warthog9/halloween-vending-machine/halloween vending machine.kicad_sch

## KiCad design halloween vending machine.kicad_sch (2023-12-08)

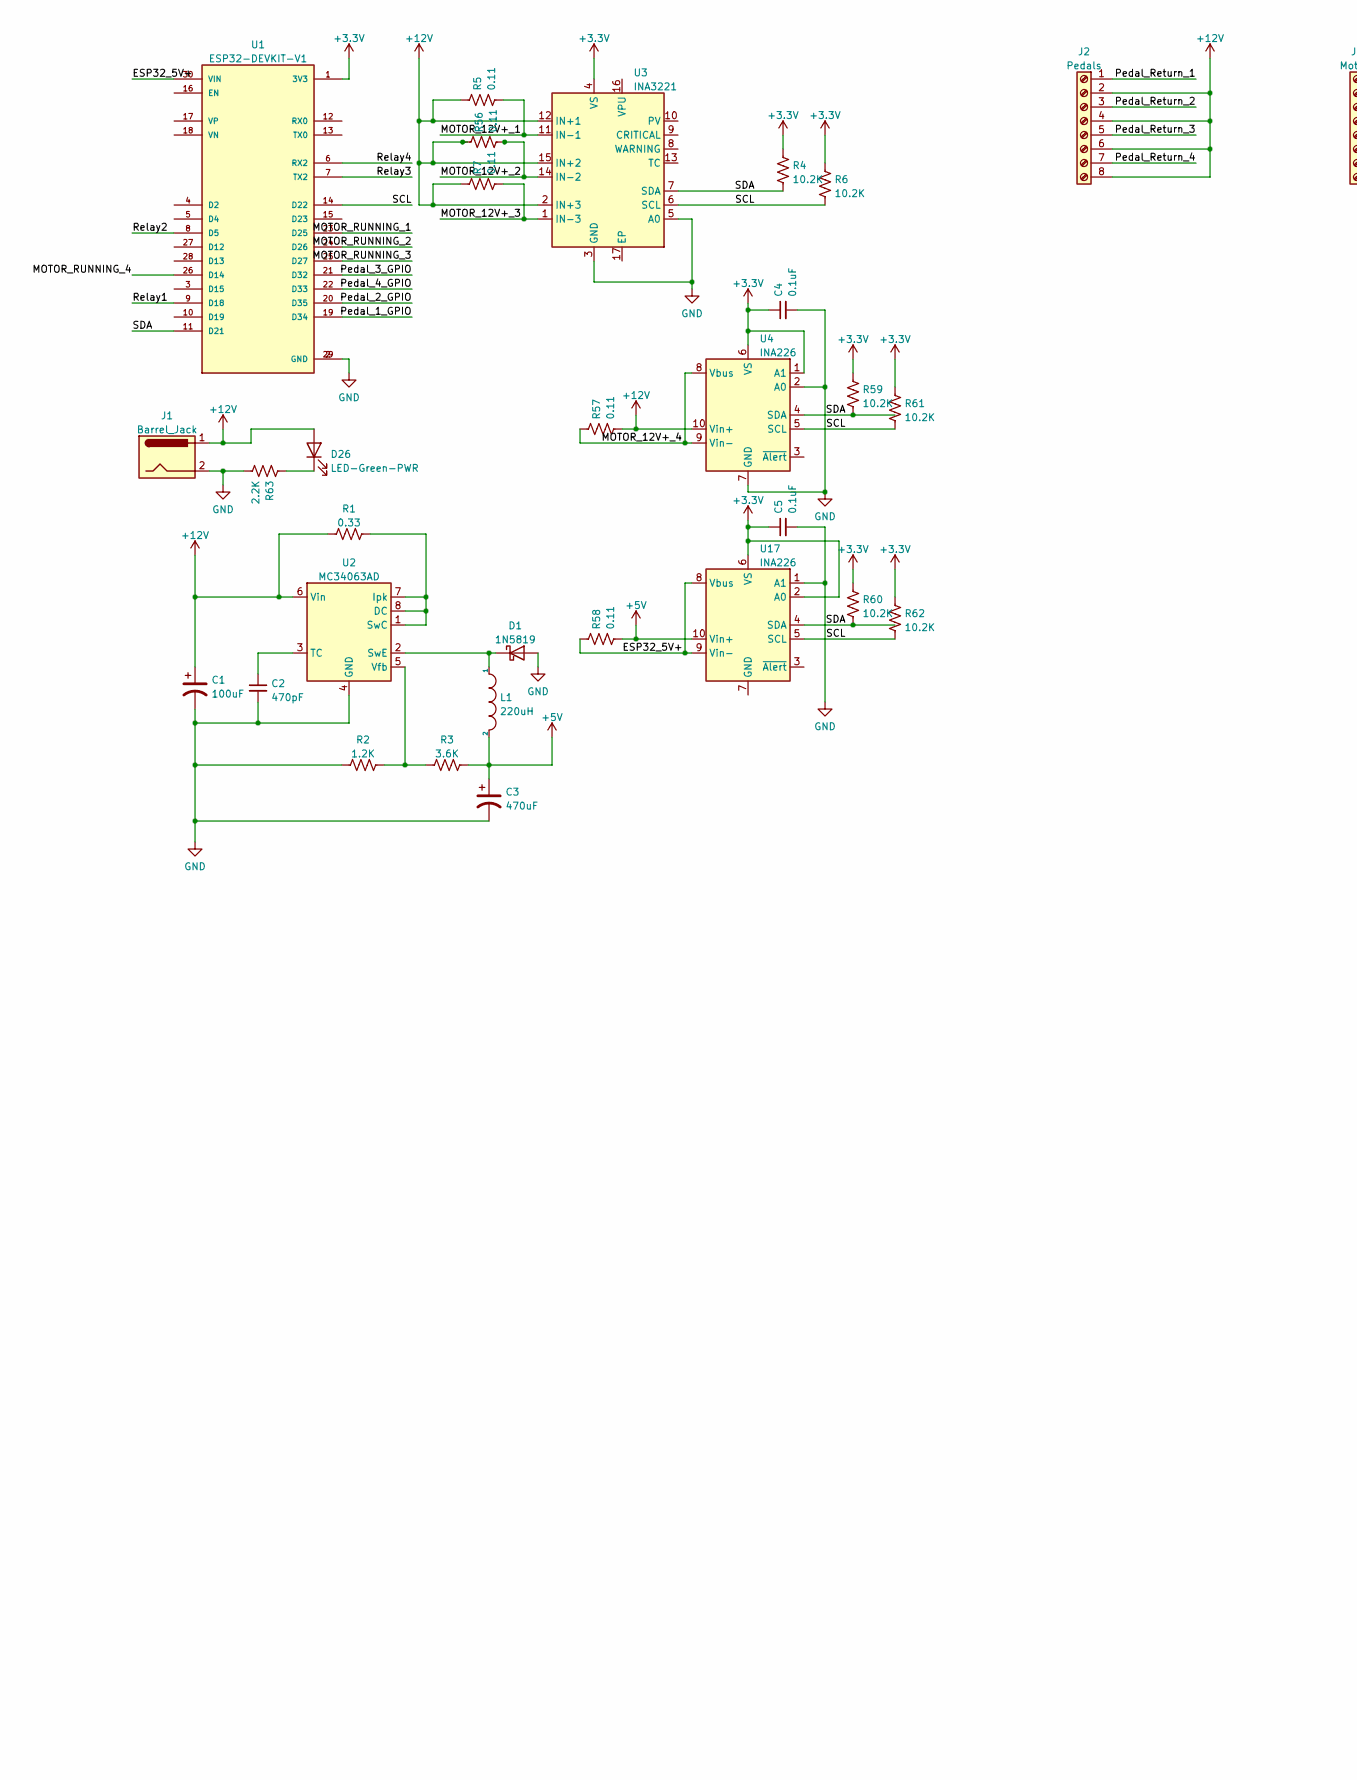
[picture p1: schematic halloween vending machine.kicad_sch, part in row 1, column 1]

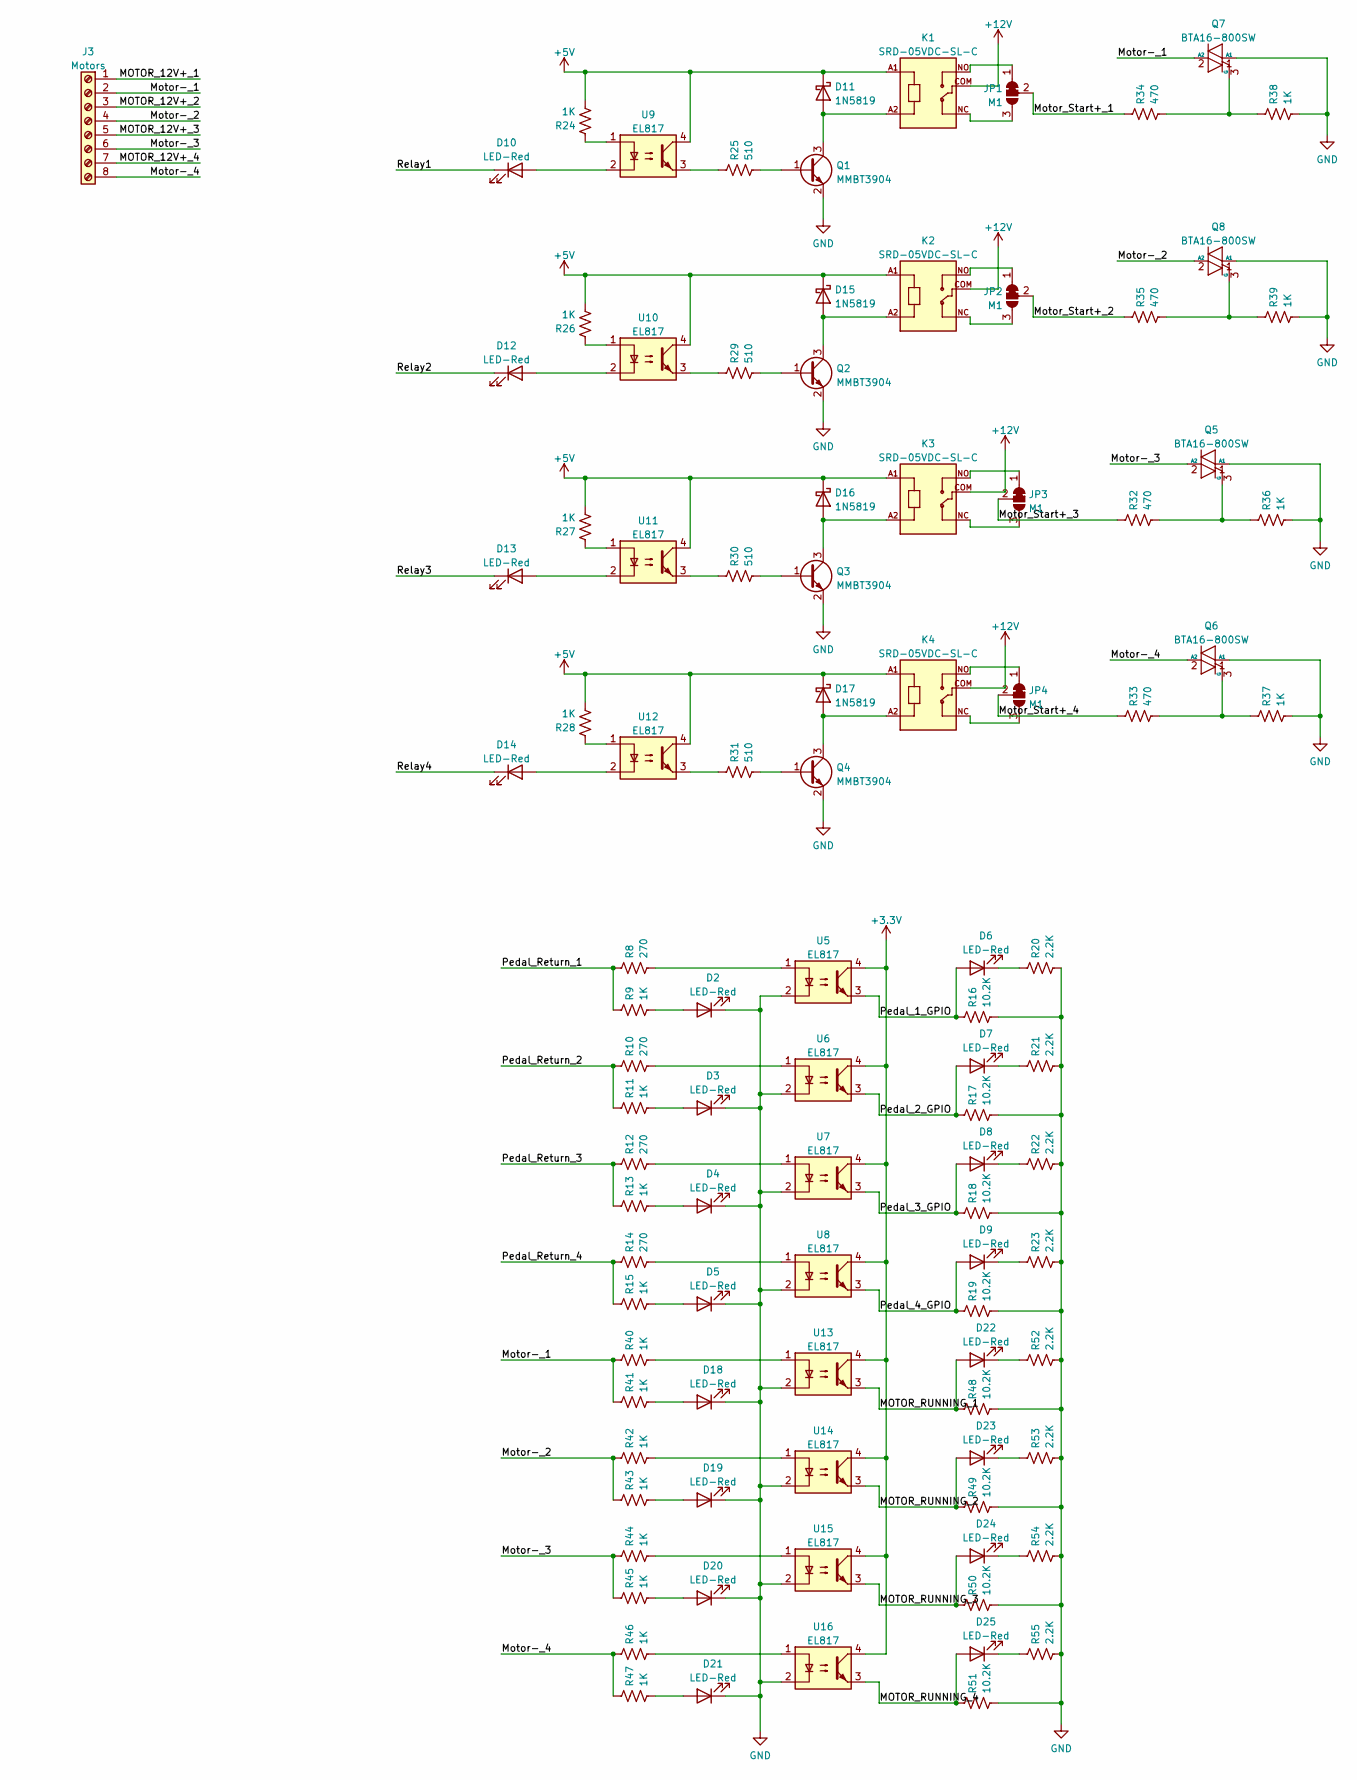
[picture p2: schematic halloween vending machine.kicad_sch, part in row 1, column 2]

Parts:
C1: 100uF; C_Elec_8x10.2; JLCPCB C280404
C2: 470pF; C_1206_3216Metric; JLCPCB C107177
C3: 470uF; C_Elec_8x10.2; JLCPCB C2858857
C4, C5: 0.1uF; C_1206_3216Metric; JLCPCB C24497
D1, D11, D15, D16, D17: 1N5819; D_DO-41_SOD81_P10.16mm_Horizontal; LCSC C402218
D2, D3, D4, D5, D6, D7, D8, D9, D10, D12, D13, D14, D18, D19, D20, D21, D22, D23, D24, D25: LED-Red; LED_0603_1608Metric; JLCPCB C2286
D26: LED-Green-PWR; LED_0603_1608Metric; JLCPCB C12624
J1: Barrel_Jack; BarrelJack_Horizontal; LCSC C194407
J2: Pedals; TerminalBlock_Phoenix_MKDS-1,5-8_1x08_P5.00mm_Horizontal; LCSC C430626
J3: Motors; TerminalBlock_Phoenix_MKDS-1,5-8_1x08_P5.00mm_Horizontal; LCSC C430626
JP1, JP2, JP3, JP4: M1; SolderJumper-3_P1.3mm_Bridged12_Pad1.0x1.5mm_NumberLabels
K1, K2, K3, K4: SRD-05VDC-SL-C; RELAY_SRD-05VDC-SL-C; LCSC C35449
L1: 220uH; L_1812_4532Metric; JLCPCB C394137
Q1, Q2, Q3, Q4: MMBT3904; SOT-23; LCSC C20526
Q5, Q6, Q7, Q8: BTA16-800SW; TO-220-3_Vertical; LCSC C2831702
R1: 0.33; R_1206_3216Metric; JLCPCB C25337
R2: 1.2K; R_1206_3216Metric; JLCPCB C17891
R3: 3.6K; R_1206_3216Metric; JLCPCB C422446
R4, R6, R16, R17, R18, R19, R48, R49, R50, R51, R59, R60, R61, R62: 10.2K; R_1206_3216Metric; JLCPCB C205053
R5, R7, R56, R57, R58: 0.11; R_1206_3216Metric; JLCPCB C159413
R8, R10, R12, R14: 270; R_1206_3216Metric; JLCPCB C137341
R9, R11, R13, R15, R24, R26, R27, R28, R36, R37, R38, R39, R40, R41, R42, R43, R44, R45, R46, R47: 1K; R_1206_3216Metric; JLCPCB C1469
R20, R21, R22, R23, R52, R53, R54, R55, R63: 2.2K; R_1206_3216Metric; JLCPCB C26038
R25, R29, R30, R31: 510; R_1206_3216Metric; JLCPCB C294789
R32, R33, R34, R35: 470; R_1206_3216Metric; JLCPCB C114945
U1: ESP32-DEVKIT-V1; MODULE_ESP32_DEVKIT_V1_NOHOLES; PARTREV N/A; LCSC C2932676
U2: MC34063AD; SOIC-8_3.9x4.9mm_P1.27mm; LCSC C32078
U3: INA3221; Texas_RGV_S-PVQFN-N16_EP2.1x2.1mm; LCSC C181255
U4, U17: INA226; VSSOP-10_3x3mm_P0.5mm; LCSC C49851
U5, U6, U7, U8, U9, U10, U11, U12, U13, U14, U15, U16: EL817; DIP-4_W7.62mm; LCSC C181890

Connections:
+3.3V: C4.1, C5.1, R4.1, R6.1, R59.1, R60.1, R61.1, R62.1, U1.1 (3V3), U3.4 (VS), U4.1 (A1), U4.6 (VS), U5.4, U6.4, U7.4, U8.4, U13.4, U14.4, U15.4, U16.4, U17.2 (A0), U17.6 (VS)
+5V: C3.1, D11.1 (K), D15.1 (K), D16.1 (K), D17.1 (K), K1.A1, K2.A1, K3.A1, K4.A1, L1.2, R3.2, R24.2, R26.2, R27.2, R28.2, R58.2, U9.4, U10.4, U11.4, U12.4, U17.10 (Vin+)
+12V: C1.1, D26.2 (A), J1.1, J2.2, J2.4, J2.6, J2.8, K1.COM, K2.COM, K3.COM, K4.COM, R1.1, R5.1, R7.1, R56.1, R57.2, U2.6 (Vin), U3.2 (IN+3), U3.12 (IN+1), U3.15 (IN+2), U4.10 (Vin+)
ESP32_5V+: R58.1, U1.30 (VIN), U17.8 (Vbus), U17.9 (Vin-)
GND: C1.2, C2.2, C3.2, C4.2, C5.2, D1.2 (A), D2.1 (K), D3.1 (K), D4.1 (K), D5.1 (K), D18.1 (K), D19.1 (K), D20.1 (K), D21.1 (K), J1.2, Q1.2 (E), Q2.2 (E), Q3.2 (E), Q4.2 (E), Q5.1 (A1), Q6.1 (A1), Q7.1 (A1), Q8.1 (A1), R2.1, R16.2, R17.2, R18.2, R19.2, R20.2, R21.2, R22.2, R23.2, R36.2, R37.2, R38.2, R39.2, R48.2, R49.2, R50.2, R51.2, R52.2, R53.2, R54.2, R55.2, R63.2, U1.2 (GND), U1.29 (GND), U2.4 (GND), U3.3 (GND), U3.5 (A0), U4.2 (A0), U4.7 (GND), U5.2, U6.2, U7.2, U8.2, U13.2, U14.2, U15.2, U16.2, U17.1 (A1)
MOTOR_12V+_1: J3.1, R5.2, U3.11 (IN-1)
MOTOR_12V+_2: J3.3, R56.2, U3.14 (IN-2)
MOTOR_12V+_3: J3.5, R7.2, U3.1 (IN-3)
MOTOR_12V+_4: J3.7, R57.1, U4.8 (Vbus), U4.9 (Vin-)
MOTOR_RUNNING_1: D22.2 (A), R48.1, U1.23 (D25), U13.3
MOTOR_RUNNING_2: D23.2 (A), R49.1, U1.24 (D26), U14.3
MOTOR_RUNNING_3: D24.2 (A), R50.1, U1.25 (D27), U15.3
MOTOR_RUNNING_4: D25.2 (A), R51.1, U1.26 (D14), U16.3
Motor-_1: J3.2, Q7.2 (A2), R40.1, R41.1
Motor-_2: J3.4, Q8.2 (A2), R42.1, R43.1
Motor-_3: J3.6, Q5.2 (A2), R44.1, R45.1
Motor-_4: J3.8, Q6.2 (A2), R46.1, R47.1
Motor_Start+_1: JP1.2 (C), R34.1
Motor_Start+_2: JP2.2 (C), R35.1
Motor_Start+_3: JP3.2 (C), R32.1
Motor_Start+_4: JP4.2 (C), R33.1
unnamed: C2.1, U2.3 (TC)
unnamed: D1.1 (K), L1.1, U2.2 (SwE)
unnamed: D2.2 (A), R9.2
unnamed: D3.2 (A), R11.2
unnamed: D4.2 (A), R13.2
unnamed: D5.2 (A), R15.2
unnamed: D6.1 (K), R20.1
unnamed: D7.1 (K), R21.1
unnamed: D8.1 (K), R22.1
unnamed: D9.1 (K), R23.1
unnamed: D10.2 (A), U9.2
unnamed: D11.2 (A), K1.A2, Q1.3 (C)
unnamed: D12.2 (A), U10.2
unnamed: D13.2 (A), U11.2
unnamed: D14.2 (A), U12.2
unnamed: D15.2 (A), K2.A2, Q2.3 (C)
unnamed: D16.2 (A), K3.A2, Q3.3 (C)
unnamed: D17.2 (A), K4.A2, Q4.3 (C)
unnamed: D18.2 (A), R41.2
unnamed: D19.2 (A), R43.2
unnamed: D20.2 (A), R45.2
unnamed: D21.2 (A), R47.2
unnamed: D22.1 (K), R52.1
unnamed: D23.1 (K), R53.1
unnamed: D24.1 (K), R54.1
unnamed: D25.1 (K), R55.1
unnamed: D26.1 (K), R63.1
unnamed: JP1.1 (A), K1.NO
unnamed: JP1.3 (B), K1.NC
unnamed: JP2.1 (A), K2.NO
unnamed: JP2.3 (B), K2.NC
unnamed: JP3.1 (A), K3.NO
unnamed: JP3.3 (B), K3.NC
unnamed: JP4.1 (A), K4.NO
unnamed: JP4.3 (B), K4.NC
unnamed: Q1.1 (B), R25.2
unnamed: Q2.1 (B), R29.2
unnamed: Q3.1 (B), R30.2
unnamed: Q4.1 (B), R31.2
unnamed: Q5.3 (G), R32.2, R36.1
unnamed: Q6.3 (G), R33.2, R37.1
unnamed: Q7.3 (G), R34.2, R38.1
unnamed: Q8.3 (G), R35.2, R39.1
unnamed: R1.2, U2.1 (SwC), U2.7 (Ipk), U2.8 (DC)
unnamed: R2.2, R3.1, U2.5 (Vfb)
unnamed: R8.2, U5.1
unnamed: R10.2, U6.1
unnamed: R12.2, U7.1
unnamed: R14.2, U8.1
unnamed: R24.1, U9.1
unnamed: R25.1, U9.3
unnamed: R26.1, U10.1
unnamed: R27.1, U11.1
unnamed: R28.1, U12.1
unnamed: R29.1, U10.3
unnamed: R30.1, U11.3
unnamed: R31.1, U12.3
unnamed: R40.2, U13.1
unnamed: R42.2, U14.1
unnamed: R44.2, U15.1
unnamed: R46.2, U16.1
Pedal_1_GPIO: D6.2 (A), R16.1, U1.19 (D34), U5.3
Pedal_2_GPIO: D7.2 (A), R17.1, U1.20 (D35), U6.3
Pedal_3_GPIO: D8.2 (A), R18.1, U1.21 (D32), U7.3
Pedal_4_GPIO: D9.2 (A), R19.1, U1.22 (D33), U8.3
Pedal_Return_1: J2.1, R8.1, R9.1
Pedal_Return_2: J2.3, R10.1, R11.1
Pedal_Return_3: J2.5, R12.1, R13.1
Pedal_Return_4: J2.7, R14.1, R15.1
Relay1: D10.1 (K), U1.9 (D18)
Relay2: D12.1 (K), U1.8 (D5)
Relay3: D13.1 (K), U1.7 (TX2)
Relay4: D14.1 (K), U1.6 (RX2)
SCL: R6.2, R61.2, R62.2, U1.14 (D22), U3.6 (SCL), U4.5 (SCL), U17.5 (SCL)
SDA: R4.2, R59.2, R60.2, U1.11 (D21), U3.7 (SDA), U4.4 (SDA), U17.4 (SDA)
